FatPanda8885/HikCtrl/README.md

## The controller for Hik Rotator
### Usage
See 海康2TD8167型重载云台的业余无线电使用说明Ver0.3.pdf
